devadit1515/spotify-turntable/src/motor_test.cpp

// ─────────────────────────────────────────────────────────────────────────────
//  motor_test.cpp — DUMB motor test. No WiFi, no Spotify, no panel.
//
//  Purpose: prove the 28BYJ-48 + ULN2003 wiring works in isolation. It just
//  half-steps the motor forever at a slow, smooth speed. Success = the driver
//  board's 4 blue LEDs chase in sequence AND the shaft slowly rotates.
//
//  Compiled ONLY by [env:motortest] (see platformio.ini). The real app and the
//  panel test are excluded, so there's no clash between their setup()/loop().
// ─────────────────────────────────────────────────────────────────────────────
#include <Arduino.h>
#include "pins.h"

// The four ULN2003 inputs, in order. If you remap in pins.h, this follows.
static const int IN[4] = { PIN_MOTOR_IN1, PIN_MOTOR_IN2, PIN_MOTOR_IN3, PIN_MOTOR_IN4 };

// 28BYJ-48 FULL-step sequence (4 phases). Two coils energised every step =
// ~2× the torque of half-step. We use full-step here so the motor can turn even
// on a weak 3.3V supply (the ESP32's 5V pin is dead on this board).
static const uint8_t SEQ[4][4] = {
  {1,1,0,0},
  {0,1,1,0},
  {0,0,1,1},
  {1,0,0,1},
};

void setup() {
  Serial.begin(115200);
  delay(300);
  Serial.println(F("\n=== MOTOR TEST (no WiFi) ==="));
  for (int i = 0; i < 4; i++) {
    pinMode(IN[i], OUTPUT);
    digitalWrite(IN[i], LOW);
  }
  Serial.printf("[test] driving IN1..IN4 on GPIO %d %d %d %d\n",
                IN[0], IN[1], IN[2], IN[3]);
  Serial.println(F("[test] shaft should turn; driver LEDs should chase."));
}

void loop() {
  static int phase = 0;
  for (int i = 0; i < 4; i++) {
    digitalWrite(IN[i], SEQ[phase][i] ? HIGH : LOW);
  }
  phase = (phase + 1) & 3;      // next of 4 full-step phases
  delay(4);                     // 4 ms/step — slow enough to build torque on 3.3V
}
