devadit1515/spotify-turntable/(commit log)

2026-07-19 Initial commit: Spotify Turntable (ESP32-S3 now-playing display)
    Firmware (PlatformIO / Arduino-ESP32), parametric OpenSCAD enclosure,
    docs, and the one-time Spotify auth tool. Firmware compiles clean.
    [coupler.scad, matrix_frame.scad, params.scad, record.scad, turntable_base.scad]
2026-07-20 Fix heap-corruption crash: construct SpotifyArduino as zero-init static (dodges library's uninitialized _refreshToken delete)
    [spotify_client.cpp]
2026-07-22 auto: checkpoint 2026-07-22 22:58
    [params.scad]
